jsfather/mystery-box/hardware/mystery-box-clock/README.fa.md

# Mystery Box — ساعت رومیزی

بدنهٔ سبز جنگلی مات، نمای استخوانی، خط مسی و پنجرهٔ یکپارچهٔ شفاف؛ Arduino سمت چپ، LCD سمت راست و دکمه بالای سمت راست. پایهٔ پهن، صفحه را ۱۲ درجه به عقب متمایل می‌کند. ابعاد خود قاب: ۱۹۰ × ۱۱۰ × ۴۰ میلی‌متر؛ پایه: ۱۵۰ × ۷۰ میلی‌متر.

## نوشته‌های بدنه

متن پشت قاب با حرف بزرگ I و نقطهٔ پایانی، به همین صورت در دو خط حک می‌شود:

> Time will tell
> how much I love you.

حروف کلاسیک Bold Italic در خود مدل سه‌بعدی با عمق ۰٫۶ میلی‌متر فرورفته‌اند؛ پشت قاب دو خط تزئینی و نام کوچک Mystery Box هم دارد. شیارهای تهویه به حاشیهٔ بالا و پایین منتقل شده‌اند و بست سیم به دو پل داخلی تبدیل شده است تا نوشته بدون بریدگی خوانده شود. نوشته از پشت دستگاه در جهت صحیح خوانده می‌شود.

برچسب‌های پهلوی چپ نیز در خود بدنه فرورفته‌اند: USB-C و 5V / DATA کنار USB، و DC IN و 6-24V کنار فیش آداپتور. زیر کلاهک دکمه MODE نوشته شده است؛ این نوشته نام عملکرد مورد نظر است و عملکرد نرم‌افزاری هنوز پیاده‌سازی نشده است. برچسب AC درج نشده، چون ورودی برد DC است. اندازهٔ قلم برچسب‌ها ۲٫۸ تا ۳٫۲ میلی‌متر است؛ یک نمونهٔ USB-C روی کوپن 07 برای کنترل خوانایی چاپ قرار دارد.

برای ظاهر شبیه محصول آماده، پس از چاپ شیارهای پشت و کنار با رنگ اکریلیک استخوانی و خطوط تزئینی با رنگ مسی پر شوند؛ MODE با سبز تیره پر شود. رنگ اضافی از سطح پاک شود. رنگ‌گذاری اختیاری است و به چاپ چندرنگ یا چسباندن برچسب کاغذی نیاز ندارد. پیش‌نمایش این رنگ‌گذاری را نشان می‌دهد. اگر روی تخت بافت‌دار چاپ می‌شود، خوانایی نوشته‌های پشت ابتدا در نمونه کنترل شود؛ تخت صاف ترجیح دارد.

منبع بررسی جمله و نسبت آن به نوشتهٔ پشت ساعت هدیهٔ کریستین در فیلم: [IMDb — Doctor Strange (2016)](https://www.imdb.com/title/tt1211837/quotes?item=qt3683267). فقط متن انتخابی شما حک شده و امضای Christine به محصول اضافه نشده است.

## وضعیت ساخت

این بسته مدل مهندسی اولیهٔ قابل چاپ است و هنوز با قطعات واقعی مونتاژ نشده. سوراخ‌های UNO از نقشهٔ رسمی استخراج شده‌اند. مرکز پورت‌ها از تصویر رسمی تخمین زده شده، پس برای تضمین فیت کابل خودت، اول کوپن تست را چاپ کن. LCD بر اساس انتخاب شما، ماژول رایج ۸۰ × ۳۶ با فاصلهٔ سوراخ‌های ۷۵ × ۳۱ میلی‌متر است؛ ماژول‌های 1602 و بک‌پک‌ها یکسان نیستند. قبل از چاپ کامل، LCD، ارتفاع اجزا و شاسی اختیاری بررسی شوند. این نسخه برای سرویس مکرر، از اینسرت برنجی رزوه‌دار استفاده می‌کند؛ چاپخانه آن‌ها را یک بار با ابزار حرارتی نصب کند. پس از آن باز و بسته کردن با پیچ‌گوشتی معمولی انجام می‌شود. فایل‌های پارامتریک و STEP برای اصلاح موجودند.

## فایل‌های چاپ

همهٔ STLها واحد میلی‌متر دارند و در جهت پیشنهادی، روی Z=0 قرار گرفته‌اند. مقیاس اسلایسر ۱۰۰٪ باشد.

- `01_body_forest.stl`: یک عدد، PETG سبز تیره مات، پشت روی تخت؛ چهار پایه برای UNO و چهار پایه برای LCD در خود قطعه وجود دارد.
- `02_front_bone.stl`: یک عدد، PETG استخوانی؛ نمای بیرونی روی تخت صاف. حفرهٔ دکمه، جای پلکسی و فرورفتگی پیچ‌ها آماده است.
- `03_glass_retainer.stl`: یک عدد، PETG سبز؛ قاب نگهدارندهٔ پلکسی از داخل.
- `04_accent_copper.stl`: یک عدد، PLA یا PETG مسی معمولی؛ با مقدار کم چسب در شیار جلویی نصب شود. فیلامنت رسانا لازم نیست.
- `05_desk_stand.stl`: یک عدد، PETG سبز؛ کف روی تخت، ساپورت موضعی زیر صفحهٔ شیب‌دار لازم است.
- `06_UNO_fit_coupon.stl`: یک عدد قبل از چاپ اصلی؛ چهار سوراخ برد و هر دو ورودی کابل را آزمایش می‌کند. قطعهٔ نهایی نیست.
- `07_LCD_button_coupon.stl`: یک عدد پیش از چاپ اصلی؛ الگوی سوراخ LCD، لقی ساقهٔ دکمه و فیت اینسرت‌ها را بررسی می‌کند.

- `08_button_cap_copper.stl`: یک عدد؛ کلاهک و ساقهٔ یکپارچهٔ مسی. نمای گرد روی تخت چاپ شود (فایل از قبل جهت‌دهی شده است).
- `09_button_capture_washer.stl`: یک عدد؛ واشر چاپی که از داخل به ساقه پیچ می‌شود و جلوی افتادن کلاهک را می‌گیرد.
- `10_button_carrier.stl`: یک عدد؛ سینی قابل بازکردن برای شاسی اختیاری یا فاصله‌گذار حالت بدون شاسی.
- `11_button_blank_spacer.stl`: یک عدد؛ فقط در حالت بدون شاسی، برای ثابت ماندن کلاهک. با نصب شاسی این قطعه برداشته می‌شود.

نازل ۰٫۴، لایهٔ ۰٫۲۰، چهار دیواره، پنج لایهٔ بالا و پایین، ۲۰ تا ۲۵٪ gyroid. برای کوپن ۱۵٪ کافی است. ساپورت بدنه فقط زیر سقف ورودی‌های کابل، در صورت نیاز اسلایسر؛ داخل سوراخ پیچ‌ها ساپورت نگذارید. برای نمای جلویی از تخت صاف استفاده شود. elephant-foot compensation حدود ۰٫۱۵ تا ۰٫۲ میلی‌متر، با کالیبراسیون چاپگر. چاپ و رنگ چندتکه به AMS نیاز ندارد.

## پنجره و دکمه

پنجره پرینت نمی‌شود: پلکسی شفاف بی‌رنگ، ضخامت ۲٫۰ میلی‌متر، ابعاد نهایی ۱۷۸ × ۶۶ و شعاع گوشهٔ ۸ میلی‌متر. SVG در پوشهٔ `laser` مقیاس واقعی دارد؛ اپراتور لیزر باید kerf را برای همین ابعاد نهایی جبران کند. پاکت قاب ۰٫۳ میلی‌متر لقی در هر طرف دارد. از پلکسی دودی و مات استفاده نکنید تا برد و LEDها مستقیم دیده شوند. شیشهٔ واقعی در این ضخامت و اتصال طراحی نشده است.

دکمهٔ نمای بیرونی اکنون خودش یک قطعهٔ پرینتی مسی است؛ خرید دکمهٔ پنلی M12 لازم نیست. کلاهک از بیرون در سوراخ راهنما وارد می‌شود و واشر چاپی با یک پیچ M2 از داخل به آن بسته می‌شود. لقی شعاعی ساقه ۰٫۳ میلی‌متر و حرکت فشردن اسمی ۰٫۶ میلی‌متر است. سطح ساقه بعد از چاپ باید صاف شود تا آزاد حرکت کند.

**بدون شاسی:** فاصله‌گذار 11 روی سینی 10 می‌نشیند و از زیر واشر، کلاهک را نگه می‌دارد. همان ظاهر کامل حفظ می‌شود؛ دکمهٔ تزئینی در این حالت کلیک نمی‌کند. قطعه بدون چسب محبوس است و بعداً قابل برداشتن است.

**با شاسی:** فاصله‌گذار را بردار و یک شاسی تاکتایل چهارپایهٔ ۶ × ۶ با ارتفاع کل ۴٫۳ میلی‌متر روی نشیمن سینی بگذار. پایه‌ها از دو شکاف بیرون می‌آیند؛ با سیم انعطاف‌پذیر مستقیم متصل شوند، نه PCB اضافی که ارتفاع را تغییر می‌دهد. برای ثابت کردن بدنه از نوار چسب باریک قابل جداشدن کنار بدنه استفاده کن؛ روی میلهٔ متحرک یا پایه‌های فلزی چسب نزن. اگر شاسی شانه یا پایهٔ متفاوت دارد، نشیمن باید اصلاح شود. ارتفاع سر پیچ نگهدارندهٔ کلاهک حداکثر ۱٫۵ میلی‌متر باشد: همین سر پیچ به شاسی فشار می‌آورد؛ فاصلهٔ هدف با نوک شاسی ۰٫۲ میلی‌متر است. با قطعهٔ واقعی بررسی کن که در حالت رها فشرده نباشد و پس از رها کردن برگردد؛ در صورت نیاز نشیمن با ورق نازک تنظیم شود. کل سینی با دو پیچ باز می‌شود.

تفاوت مدل‌های شاسی و چاپگرها نیاز به آزمون فیزیکی دارد؛ اندازهٔ ۶ × ۶ به‌تنهایی کافی نیست، ارتفاع کل نیز باید ۴٫۳ میلی‌متر باشد. عملکرد و سیم‌کشی دکمه در این بسته پیاده‌سازی نشده است.

## پیچ و لوازم

- اینسرت‌ها را چاپخانه پیش از نصب مدار با ابزار حرارتی نصب کند؛ برای جا زدن، به قطعهٔ سرد فشار وارد نکند. اندازه‌ها برای **اینسرت برنجی حرارتی** با قطر بیرونی مشخص است، نه مهرهٔ شش‌گوش معمولی.
- چهار اینسرت M3 با قطر بیرونی ۴٫۶ و طول ۴ میلی‌متر برای بدنه، سوراخ اولیه ۴٫۲؛ چهار پیچ ماشینی M3 × ۸ سر عدسی با قطر سر حداکثر ۶ و ارتفاع حداکثر ۲. این چهار پیچ برای باز کردن قاب کافی‌اند؛ ابزار یک پیچ‌گوشتی معمولی است.
- پانزده اینسرت M2 با قطر بیرونی ۳٫۲ و طول ۳ میلی‌متر، سوراخ اولیه ۲٫۹: چهار UNO، چهار LCD، چهار قاب پلکسی، دو سینی دکمه و یکی داخل ساقهٔ کلاهک. سطح اینسرت با سطح تکیه‌گاه هم‌سطح شود و بیرون نزند. از یک اینسرت اضافی M2 و M3 برای آزمون کوپن استفاده کنید. ابعاد اینسرت فروشنده باید با این مشخصات منطبق باشد؛ نتیجهٔ کوپن بر اندازهٔ اولیه اولویت دارد.
- هشت پیچ ماشینی M2 × ۴ برای برد و LCD، سر UNO حداکثر قطر ۴ میلی‌متر. زیر سر پیچ نزدیک هدرها از واشر بزرگ استفاده نشود. تکیه‌گاه UNO در Z=8 و LCD در Z=22 است. زیر LCD حدود ۱۹ میلی‌متر فضای بک‌پک هست و ارتفاع مجموعه از تکیه‌گاه تا زیر پلکسی حداکثر ۱۲ میلی‌متر است.
- چهار پیچ ماشینی M2 × ۵ برای قاب پلکسی؛ دو M2 × ۶ برای سینی دکمه و یک M2 × ۶ برای واشر کلاهک. سر پیچ کلاهک حداکثر ارتفاع ۱٫۵ میلی‌متر داشته باشد. پیچ کلاهک باید واشر را به ساقه محکم کند، نه ساقه را به قاب؛ کلاهک در حالت شاسی‌دار آزاد حرکت کند.
- پایه: دو پیچ ماشینی M3 × ۱۲، دو مهرهٔ شش‌گوش M3؛ مهره‌ها در پاکت شش‌گوش داخل بدنه می‌نشینند و نمی‌چرخند. از کانال باز پشت پایه، پیچ‌گوشتی به سر پیچ دسترسی دارد؛ سر پیچ تا پشت صفحهٔ شیب‌دار در کانال فرو می‌رود. واشر اضافه نکنید چون طول پیچ برای همین اتصال انتخاب شده است. پیش از نصب بردها ببندید.
- چهار پد لاستیکی چسب‌دار قطر ۱۰ × ضخامت ۲ میلی‌متر، در فرورفتگی زیر پایه.
- سیم I2C نرم و کوتاه حدود ۱۰ تا ۱۵ سانتی‌متر، بست کوچک برای مهار به پشت قاب. USB و فیش تغذیه را در کوپن، با همان کابل نهایی تست کنید؛ کابل‌هایی با روکش بسیار ضخیم ممکن است به بزرگ‌کردن دهانه نیاز داشته باشند.

## ترتیب مونتاژ

۱. کوپن‌ها را چاپ و با برد، LCD، کابل، ساقهٔ کلاهک و اینسرت‌ها تطبیق بده؛ برد بدون فشار یا خم‌شدن باید روی هر چهار تکیه‌گاه بنشیند.
۲. چاپخانه ابتدا اینسرت‌ها را نصب کند؛ سپس پایه را به پشت بدنه پیچ کن؛ مهره‌ها داخل بدنه قرار می‌گیرند. پدها را زیر پایه بچسبان.
۳. برد را با هر چهار پیچ و LCD را با هر چهار پیچ نصب کن. مسیر سیم را از فاصلهٔ میان دو برد عبور بده، به پشت مهار کن و از روی ماتریس و آنتن دور نگه دار. هیچ سیمی زیر PCB فشرده نشود.
۴. روکش محافظ پلکسی را بردار؛ پلکسی را از داخل نمای جلو در پاکت بنشان و قاب نگهدارنده را با چهار پیچ ببند. پلکسی را تحت فشار خم نکن.
۵. کلاهک را از بیرون وارد کن؛ واشر را از داخل با پیچ M2 ببند. سینی را با فاصله‌گذار بدون شاسی، یا با شاسی و بدون فاصله‌گذار نصب کن. دو پیچ سینی را ببند. خط مسی را با چسب کم داخل شیار جا بزن.
۶. کابل‌ها را آزمایشی وصل کن؛ سپس نمای جلو را با چهار پیچ ببند. هیچ پیچ فلزی نباید با مس یا قطعات برد تماس پیدا کند.

برای سرویس معمولی فقط چهار پیچ اصلی را باز کن و نمای جلو را آرام بلند کن؛ برد و LCD روی بدنه باقی می‌مانند. تا قبل از سیم‌کشی دکمه، جلو بدون کابل جدا می‌شود. اگر بعداً دکمه وصل شد، روی سیم‌های آن یک کانکتور دوپین جداشدنی و حدود ۱۰ سانتی‌متر سیم آزاد بگذار تا جداکردن جلو آسان بماند. برای تعویض شاسی، فقط دو پیچ سینی را باز کن؛ پلکسی نیازی به باز شدن ندارد. اینسرت‌ها در جای خود باقی می‌مانند. پیچ‌ها را فقط تا نشستن قطعات سفت کن.

تغذیهٔ گرد روی UNO، ورودی **DC** است؛ منظور از «AC» در درخواست همین جای آداپتور در نظر گرفته شده. برق شهر یا AC مستقیم به برد وارد نمی‌شود. از آداپتور DC مناسب UNO استفاده شود.

## مبنای ابعاد و فایل قابل ویرایش

مختصات از گوشهٔ پایین چپ PCB، با پورت‌ها در چپ: (13.97, 2.54)، (66.04, 7.62)، (66.04, 35.56)، (15.24, 50.80) میلی‌متر. ابعاد برد ۶۸٫۵۸ × ۵۳٫۳۴ و سوراخ‌ها قطر ۳٫۲ میلی‌متر. منبع: [نقشهٔ مکانیکی رسمی Arduino](https://raw.githubusercontent.com/arduino/docs-content/main/content/hardware/uno/boards/uno-r4-wifi/datasheet/assets/mechanicalDrawingWiFi.png)، [نمای بالای رسمی](https://raw.githubusercontent.com/arduino/docs-content/main/content/hardware/uno/boards/uno-r4-wifi/datasheet/assets/topViewWiFi.png)، [دیتاشیت](https://docs.arduino.cc/resources/datasheets/ABX00087-datasheet.pdf).

`source/build.py` مدل پارامتریک CadQuery است؛ STEP هر قطعه و STEP مونتاژ نیز موجودند. مقادیر ارتفاع LCD، جای برد و مرکز پورت‌ها در همین فایل قابل اصلاح‌اند. `validation.json` نتیجهٔ بررسی بسته‌بودن مش، تعداد حجم‌ها و ابعاد چاپ را ثبت می‌کند. این بررسی جای تست فیت و کنترل در اسلایسر را نمی‌گیرد.
