jsfather/mystery-box/hardware/mystery-box-clock/START-HERE.fa.md

# راهنمای سادهٔ Mystery Box

این پوشه را کامل به چاپخانه بده و بگو: «اول قطعات تست 06 و 07 را چاپ کنید. بعد از تأیید فیت با قطعات واقعی، بقیهٔ قطعات را طبق PRINT-SHOP.txt چاپ کنید و اینسرت‌های برنجی را هم خودتان نصب کنید. دکمه فعلاً در حالت بدون شاسی مونتاژ شود.» پنجرهٔ شفاف باید از پلکسی ۲ میلی‌متری برش بخورد؛ فایلش در پوشهٔ laser است.

**باز کردن ساعت:** برق را جدا کن. چهار پیچ گوشه‌های جلویی را باز کن و نما را آرام بلند کن؛ برد و LCD روی بدنه باقی می‌مانند. اگر بعداً دکمه سیم داشت، کانکتور آن را جدا کن. لازم نیست پیچ‌های برد، شیشه یا پایه را باز کنی.

**بستن ساعت:** اگر سیم دکمه وجود دارد، کانکتورش را وصل کن. سیم‌ها را داخل بگذار، نمای جلو را سر جایش بنشان و همان چهار پیچ را آرام ببند. چون رزوه‌ها فلزی‌اند، برای باز و بسته کردن مکرر مناسب‌ترند؛ پیچ‌ها را بیش از حد سفت نکن.

**دکمه بدون شاسی:** قطعهٔ مسی همیشه وجود دارد. فاصله‌گذار داخلی آن را ثابت نگه می‌دارد؛ سوراخ خالی یا قطعهٔ آویزان دیده نمی‌شود.

**اضافه کردن شاسی در آینده:** جلو را باز کن، دو پیچ سینی دکمه را باز کن، فاصله‌گذار شمارهٔ 11 را بردار و شاسی ۶×۶ با ارتفاع کل ۴٫۳ میلی‌متر را جایگزین کن. بعد از نصب باید دکمه روان فشار بخورد و برگردد. نصب شاسی و سیم‌کشی را به فردی که مونتاژ الکترونیک بلد است بسپار؛ راهنمای دقیق در README.fa.md است. شاسی در این نسخه عملکرد نرم‌افزاری ندارد.

فایل‌ها از نظر هندسی بررسی شده‌اند؛ فیت واقعی هنوز آزمایش نشده است. چاپ قطعات تست قبل از کل قاب ضروری است.

**نوشته‌ها:** جملهٔ پشت و نام ورودی‌ها در خود فایل حک شده‌اند. از چاپخانه بخواه برای خواناتر شدن، شیارها را با رنگ روشن پر کند؛ نمونهٔ برچسب ریز روی کوپن 07 چاپ شود.
