jsfather/mystery-box/docs/control-room.png

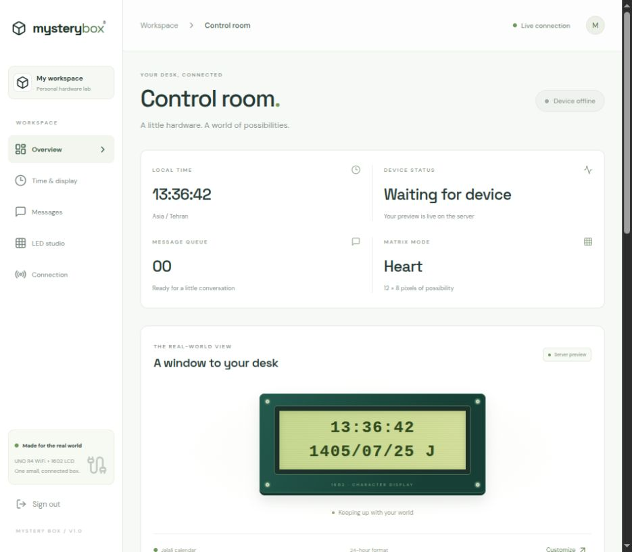
docs/control-room.png
