jsfather/mystery-box/docs/love-preview.png

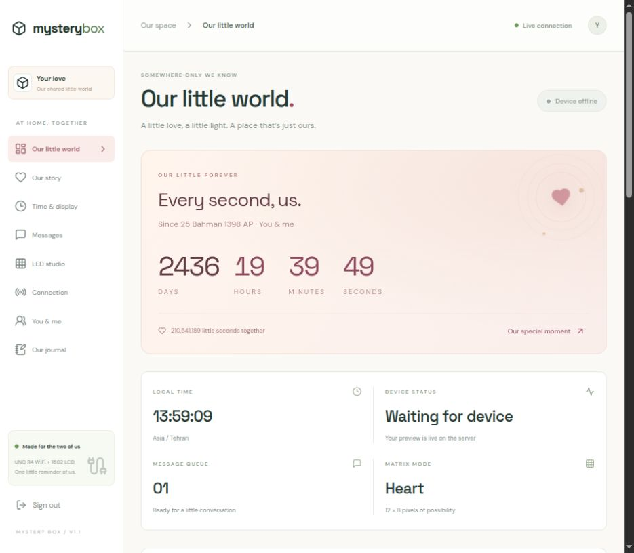
docs/love-preview.png
