jsfather/mystery-box/hardware/mystery-box-clock/preview/Mystery-Box-ports.png

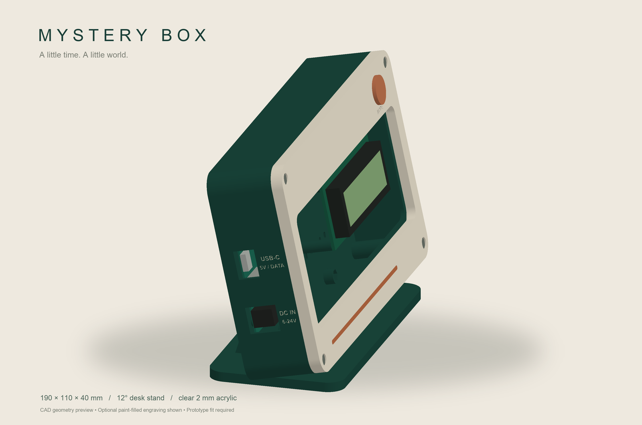
hardware/mystery-box-clock/preview/Mystery-Box-ports.png
