jsfather/mystery-box/hardware/mystery-box-clock/preview/Mystery-Box-rear.png

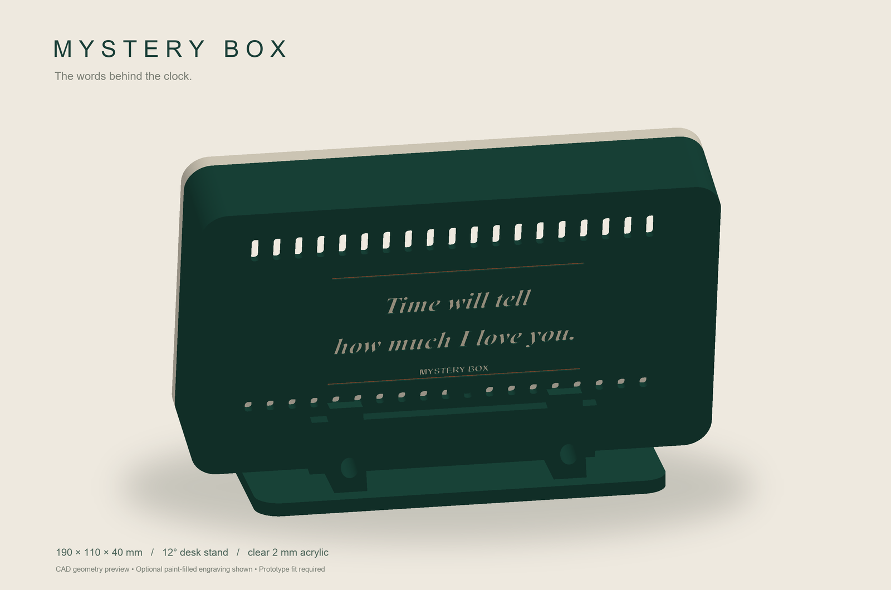
hardware/mystery-box-clock/preview/Mystery-Box-rear.png
