jsfather/mystery-box/hardware/mystery-box-clock/preview/Mystery-Box.png

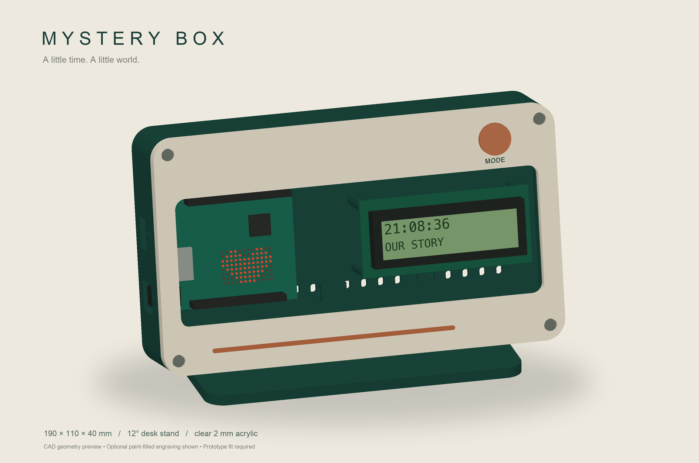
hardware/mystery-box-clock/preview/Mystery-Box.png
