jsfather/mystery-box/hardware/mystery-box-clock/Mystery-Box-assembly.step

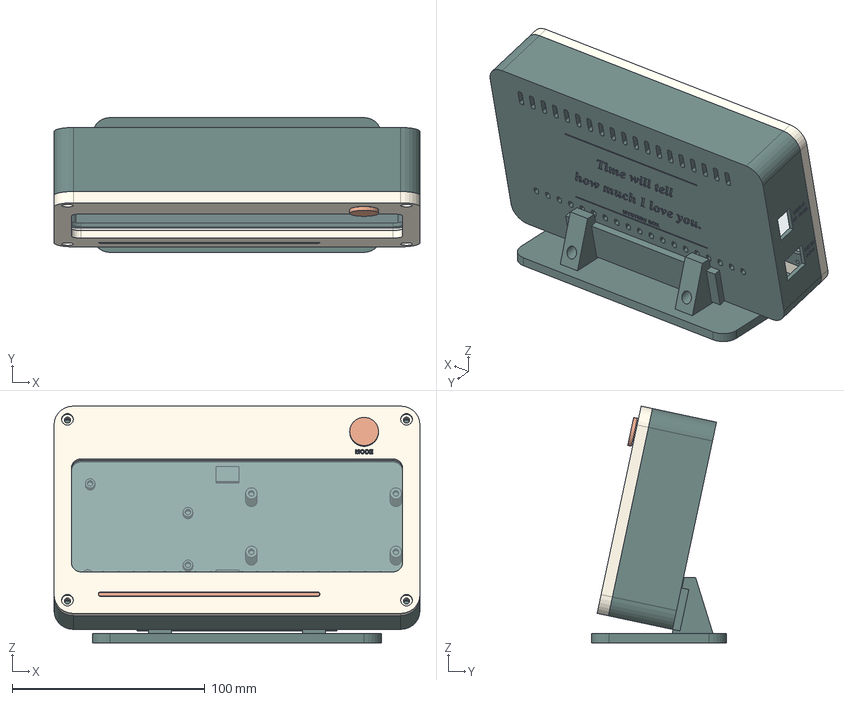
[picture p6: CAD file, 2026-10-19]
hardware/mystery-box-clock/Mystery-Box-assembly.step
190.0 x 70.0 x 122.9 mm
01_body_forest
02_front_bone
03_glass_retainer
04_accent_copper
05_desk_stand
button_cap
capture_washer
button_carrier
NO_SWITCH_spacer_REMOVE_before_switch
CUT_clear_acrylic_2mm
