jsfather/mystery-box/hardware/mystery-box-clock/preview/01_body_forest.stl

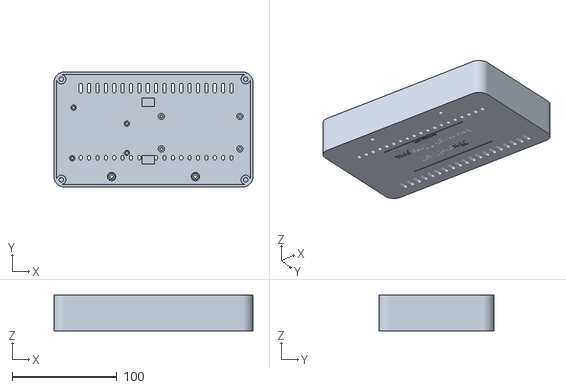
[picture p7: CAD file, 2026-10-19]
hardware/mystery-box-clock/preview/01_body_forest.stl
190.0 x 110.0 x 34.0
