jsfather/mystery-box/hardware/mystery-box-clock/source/03_glass_retainer.step

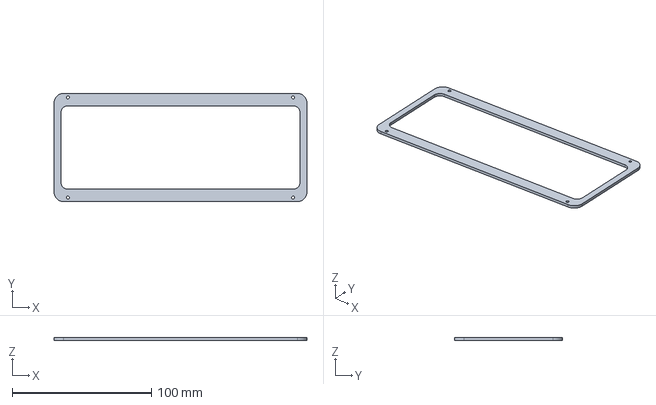
[picture p8: CAD file, 2026-10-19]
hardware/mystery-box-clock/source/03_glass_retainer.step
182.0 x 78.0 x 2.00 mm
