jsfather/mystery-box/hardware/mystery-box-clock/preview/04_accent_copper.stl

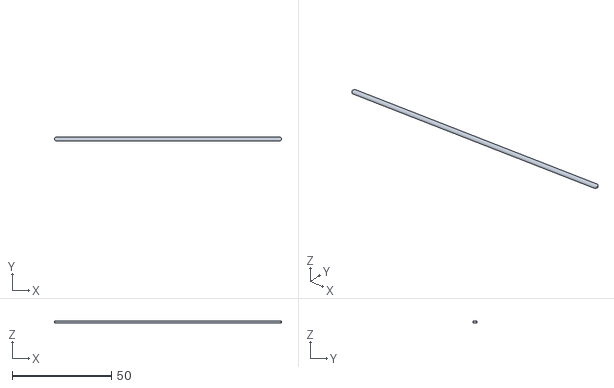
[picture p9: CAD file, 2026-10-19]
hardware/mystery-box-clock/preview/04_accent_copper.stl
114.6 x 2.00 x 0.8
