jsfather/mystery-box/hardware/mystery-box-clock/source/11_button_blank_spacer.step

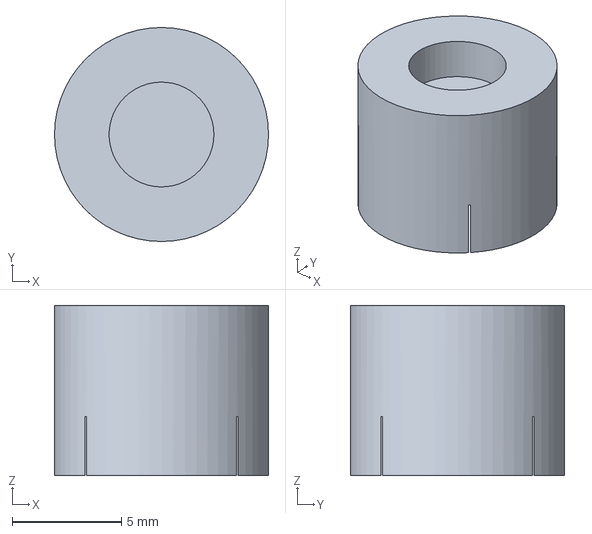
[picture p10: CAD file, 2026-10-19]
hardware/mystery-box-clock/source/11_button_blank_spacer.step
9.80 x 9.80 x 7.80 mm
