jsfather/mystery-box/hardware/mystery-box-clock/preview/acrylic.stl

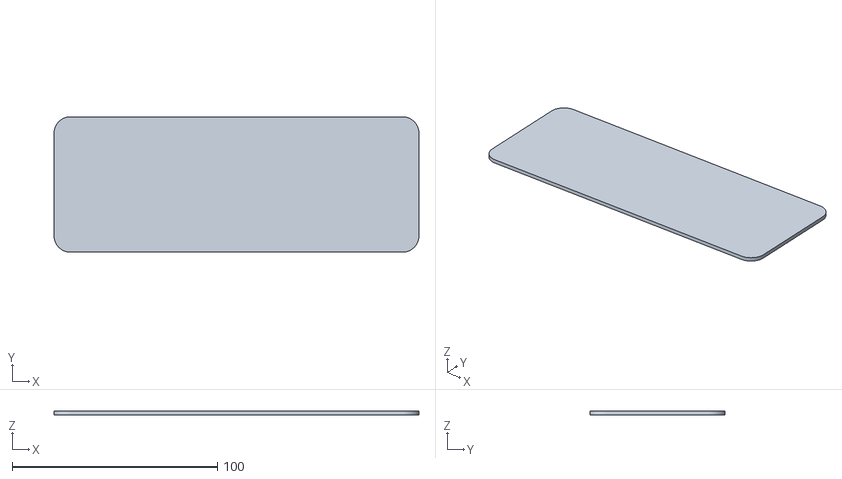
[picture p11: CAD file, 2026-10-19]
hardware/mystery-box-clock/preview/acrylic.stl
178.0 x 66.0 x 2.00
