jsfather/mystery-box/hardware/mystery-box-clock/source/06_UNO_fit_coupon.step

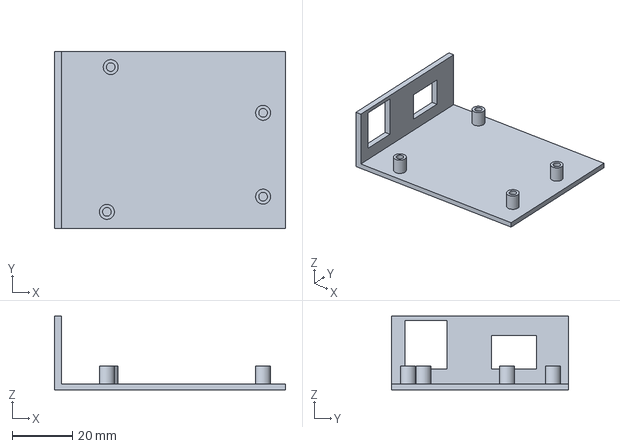
[picture p12: CAD file, 2026-10-19]
hardware/mystery-box-clock/source/06_UNO_fit_coupon.step
77.0 x 59.0 x 24.5 mm
