jsfather/mystery-box/hardware/mystery-box-clock/preview/02_front_bone.stl

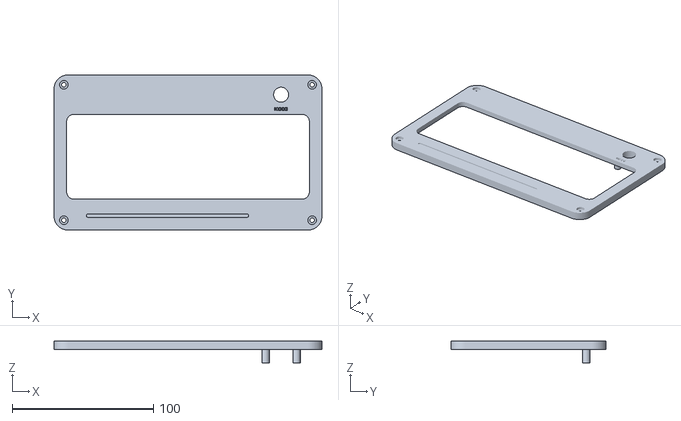
[picture p13: CAD file, 2026-10-19]
hardware/mystery-box-clock/preview/02_front_bone.stl
190.0 x 110.0 x 15.5
