jsfather/mystery-box/hardware/mystery-box-clock/source/05_desk_stand.step

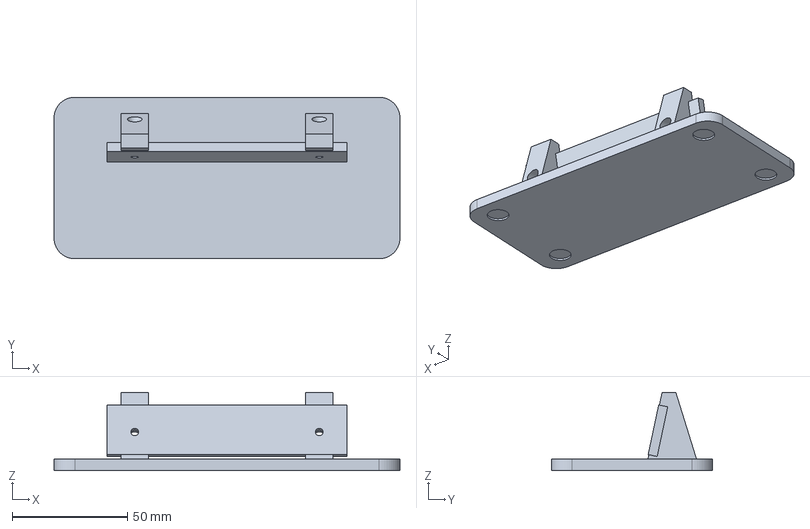
[picture p14: CAD file, 2026-10-19]
hardware/mystery-box-clock/source/05_desk_stand.step
150.0 x 70.0 x 34.0 mm
