jsfather/mystery-box/hardware/mystery-box-clock/source/08_button_cap_copper.step

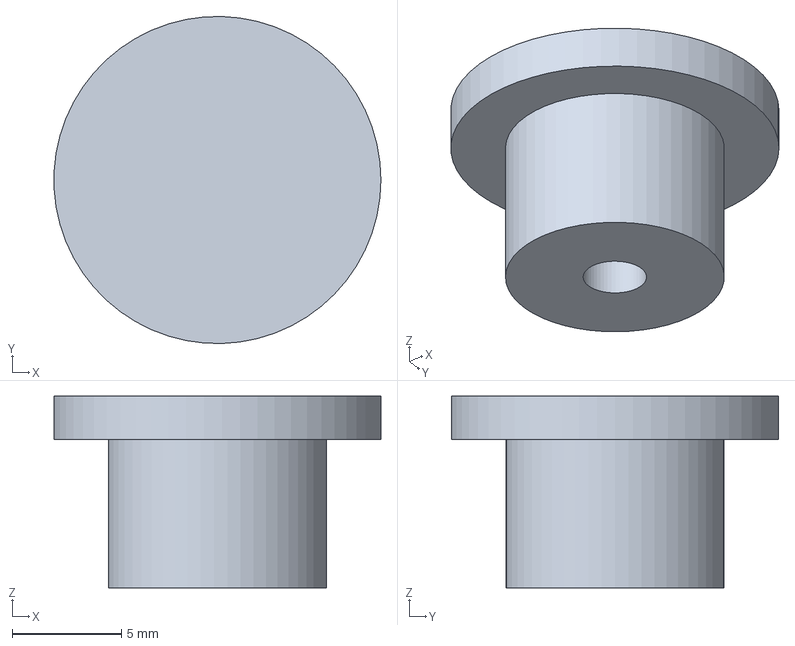
[picture p15: CAD file, 2026-10-19]
hardware/mystery-box-clock/source/08_button_cap_copper.step
15.0 x 15.0 x 8.80 mm
