jsfather/mystery-box/hardware/mystery-box-clock/source/10_button_carrier.step

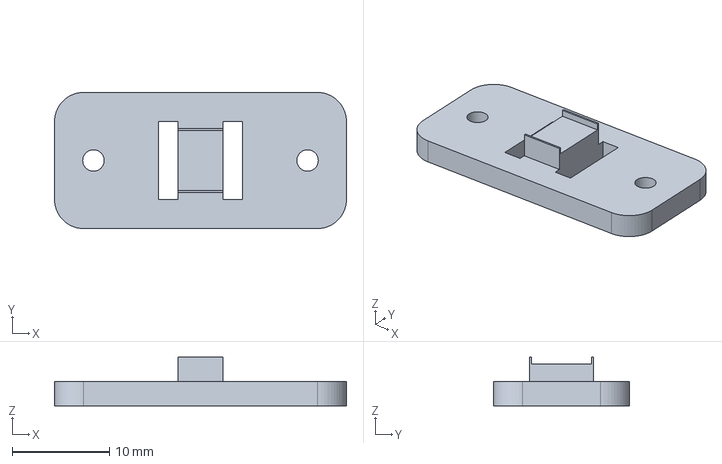
[picture p16: CAD file, 2026-10-19]
hardware/mystery-box-clock/source/10_button_carrier.step
30.0 x 14.0 x 5.00 mm
