jsfather/mystery-box/hardware/mystery-box-clock/source/07_LCD_button_coupon.step

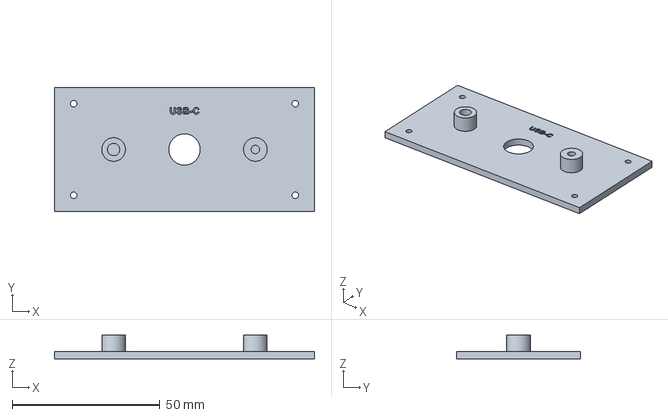
[picture p17: CAD file, 2026-10-19]
hardware/mystery-box-clock/source/07_LCD_button_coupon.step
88.0 x 42.0 x 8.00 mm
