jsfather/mystery-box/hardware/mystery-box-clock/source/09_button_capture_washer.step

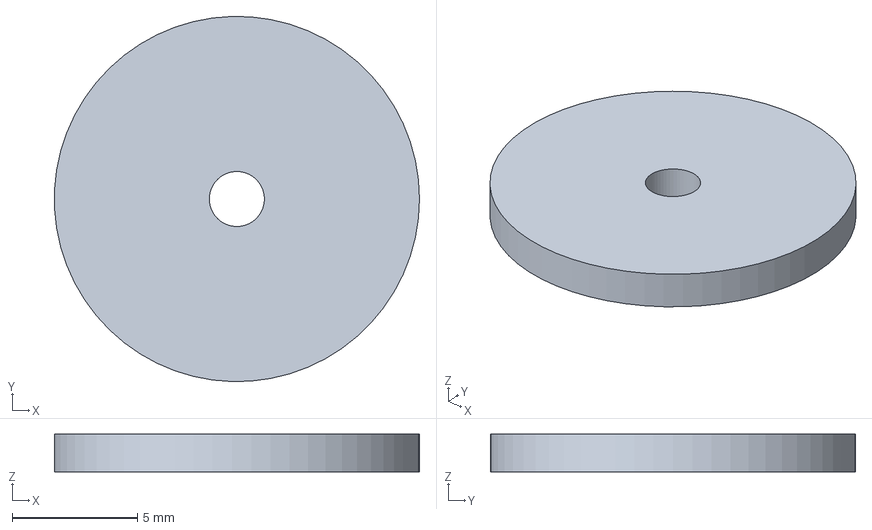
[picture p18: CAD file, 2026-10-19]
hardware/mystery-box-clock/source/09_button_capture_washer.step
14.6 x 14.6 x 1.50 mm
