jsfather/mystery-box/(list of files, cad)

Other CAD files:
hardware/mystery-box-clock/source/02_front_bone.step
hardware/mystery-box-clock/preview/03_glass_retainer.stl
hardware/mystery-box-clock/preview/05_desk_stand.stl
hardware/mystery-box-clock/source/04_accent_copper.step
hardware/mystery-box-clock/source/01_body_forest.step
hardware/mystery-box-clock/print/01_body_forest.stl
hardware/mystery-box-clock/print/02_front_bone.stl
hardware/mystery-box-clock/print/03_glass_retainer.stl
hardware/mystery-box-clock/print/04_accent_copper.stl
hardware/mystery-box-clock/print/05_desk_stand.stl
hardware/mystery-box-clock/print/06_UNO_fit_coupon.stl
hardware/mystery-box-clock/print/07_LCD_button_coupon.stl
hardware/mystery-box-clock/print/08_button_cap_copper.stl
hardware/mystery-box-clock/print/09_button_capture_washer.stl
hardware/mystery-box-clock/print/10_button_carrier.stl
hardware/mystery-box-clock/print/11_button_blank_spacer.stl
