jsfather/mystery-box/arduino/mystery-box/mystery-box.ino

/*
  ArduinoMqttClient - WiFi Simple Receive

  This example connects to a MQTT broker and subscribes to a single topic.
  When a message is received it prints the message to the Serial Monitor.

  The circuit:
  - Arduino MKR 1000, MKR 1010 or Uno WiFi Rev2 board

  This example code is in the public domain.
*/

#include <ArduinoMqttClient.h>
#include <WiFiS3.h>
#include "arduino_secrets.h"

// To connect with SSL/TLS:
// 1) Change WiFiClient to WiFiSSLClient.
// 2) Change port value from 1883 to 8883.
// 3) Change broker value to a server with a known SSL/TLS root certificate 
//    flashed in the WiFi module.

WiFiClient wifiClient;
MqttClient mqttClient(wifiClient);

const char broker[] = "192.168.1.103";
int        port     = 1883;
const char topic[]  = "message";

void setup() {
  //Initialize serial and wait for port to open:
  Serial.begin(9600);
  while (!Serial) {
    ; // wait for serial port to connect. Needed for native USB port only
  }

  // attempt to connect to WiFi network:
  Serial.print("Attempting to connect to WPA SSID: ");
  Serial.println(ssid);
  while (WiFi.begin(ssid, pass) != WL_CONNECTED) {
    // failed, retry
    Serial.print(".");
    delay(5000);
  }

  Serial.println("You're connected to the network");
  Serial.println();

  // You can provide a unique client ID, if not set the library uses Arduino-millis()
  // Each client must have a unique client ID
  // mqttClient.setId("clientId");

  // You can provide a username and password for authentication
  // mqttClient.setUsernamePassword("username", "password");

  Serial.print("Attempting to connect to the MQTT broker: ");
  Serial.println(broker);

  if (!mqttClient.connect(broker, port)) {
    Serial.print("MQTT connection failed! Error code = ");
    Serial.println(mqttClient.connectError());

    while (1);
  }

  Serial.println("You're connected to the MQTT broker!");
  Serial.println();

  Serial.print("Subscribing to topic: ");
  Serial.println(topic);
  Serial.println();

  // subscribe to a topic
  mqttClient.subscribe(topic);

  // topics can be unsubscribed using:
  // mqttClient.unsubscribe(topic);

  Serial.print("Waiting for messages on topic: ");
  Serial.println(topic);
  Serial.println();
}

void loop() {
  int messageSize = mqttClient.parseMessage();
  if (messageSize) {
    // we received a message, print out the topic and contents
    Serial.print("Received a message with topic '");
    Serial.print(mqttClient.messageTopic());
    Serial.print("', length ");
    Serial.print(messageSize);
    Serial.println(" bytes:");

    // use the Stream interface to print the contents
    while (mqttClient.available()) {
      Serial.print((char)mqttClient.read());
    }
    Serial.println();

    Serial.println();
  }
}
