jsfather/mystery-box/(commit log)

2025-07-04 arduino_secrets.h replaced by old one
2025-07-04 communicate with arduino refactored to mqtt
2026-10-17 Refactor UI components and styles for improved user experience
    - Removed deprecated search box styles from love.css and theme.css.
    - Introduced new MessageSearch component for searching messages in conversations.
    - Added ConversationMessage component to handle individual message display with options.
    - Created HeaderControls component to manage theme and connection status in the header.
    - Updated main.tsx to integrate new components and improve layout responsiveness.
    - Enhanced mobile theme button functionality and accessibility.
    - Adjusted CSS styles for better alignment and visual consistency across components.
2026-10-17 Run heart pulses on the matrix hardware timer
2026-10-17 Keep streamed matrix fallback until the device confirms local playback
2026-10-19 Add CAD design and rendering scripts for Mystery Box clock enclosure
    - Implemented `build.py` to create 3D models of the enclosure using CadQuery.
    - Added `render.py` for generating orthographic illustrations from CAD meshes.
    - Included `requirements.txt` to specify dependencies: CadQuery, trimesh, and Pillow.
    - Generated `validation.json` to report on the 3D models' properties and typography features.
2026-10-26 Scroll LCD messages locally and add device error diagnostics
2026-10-26 Add playable Snake and reduce LCD scrolling stalls
2026-10-26 Show stationary error codes on the LED matrix
